alextrical/ESP8266-Sentinel-Kinetic-Wired-Remote/README.md

# ESP8266-Vent-Axia-Sentinel-Kinetic-Wired-Remote-Controller
ESP8266 based Re-implementation of the Vent-Axia Sentinel Kinetic Wired Remote Controller
Firmware to be checked over once the PCB is manufactured, but Arduino sketch can be simulated here
https://wokwi.com/projects/427157112827024385
