alextrical/ESP8266-Sentinel-Kinetic-Wired-Remote/Enclosure.stl

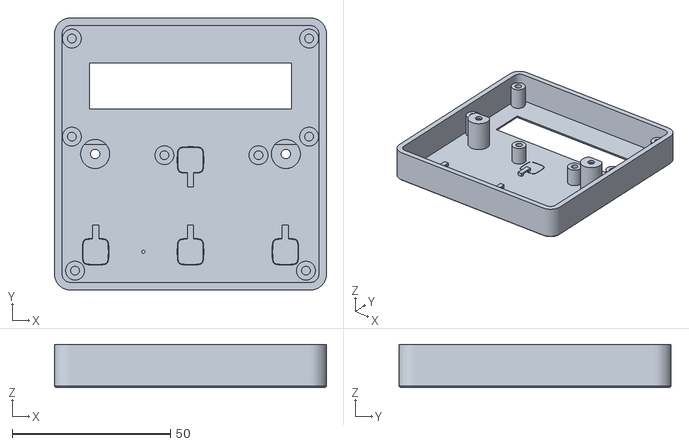
[picture p1: CAD file, 2025-04-12]
Enclosure.stl
86.0 x 86.0 x 13.6
