alextrical/ESP8266-Sentinel-Kinetic-Wired-Remote/ESP8266-Sentinel-Kinetic-Wired-Remote.pdf

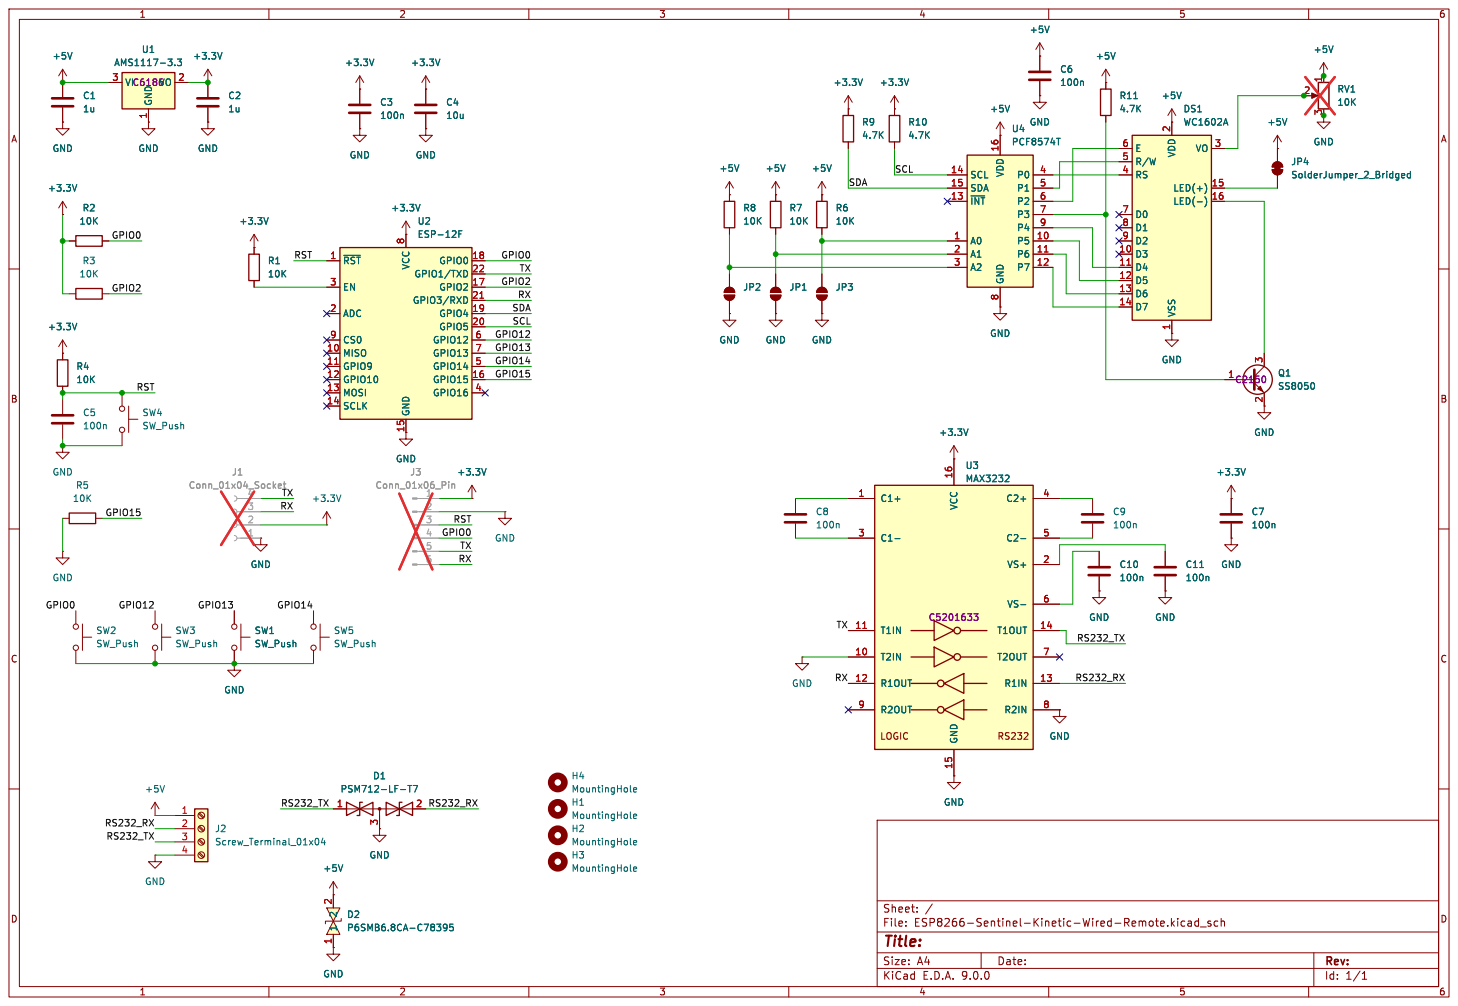
[picture p2: page 1]

8 GND 15 GPIO0 18 GPIO1/TXD 22 GPIO2 17 GPIO3/RXD 21 GPIO4 19 GPIO5 20 GPIO12 6 GPIO13 7 GPIO14 5 GPIO15 16 GPIO16 4 +3.3V GND GND
J3 Conn_01x06_Pin GND

Id: 1/1 Title: File: ESP8266-Sentinel-Kinetic-Wired-Remote.kicad_sch Sheet: / C8
