alextrical/ESP8266-Sentinel-Kinetic-Wired-Remote/ESP8266-Sentinel-Kinetic-Wired-Remote.kicad_pcb

## KiCad design ESP8266-Sentinel-Kinetic-Wired-Remote.kicad_pcb (2025-04-13)

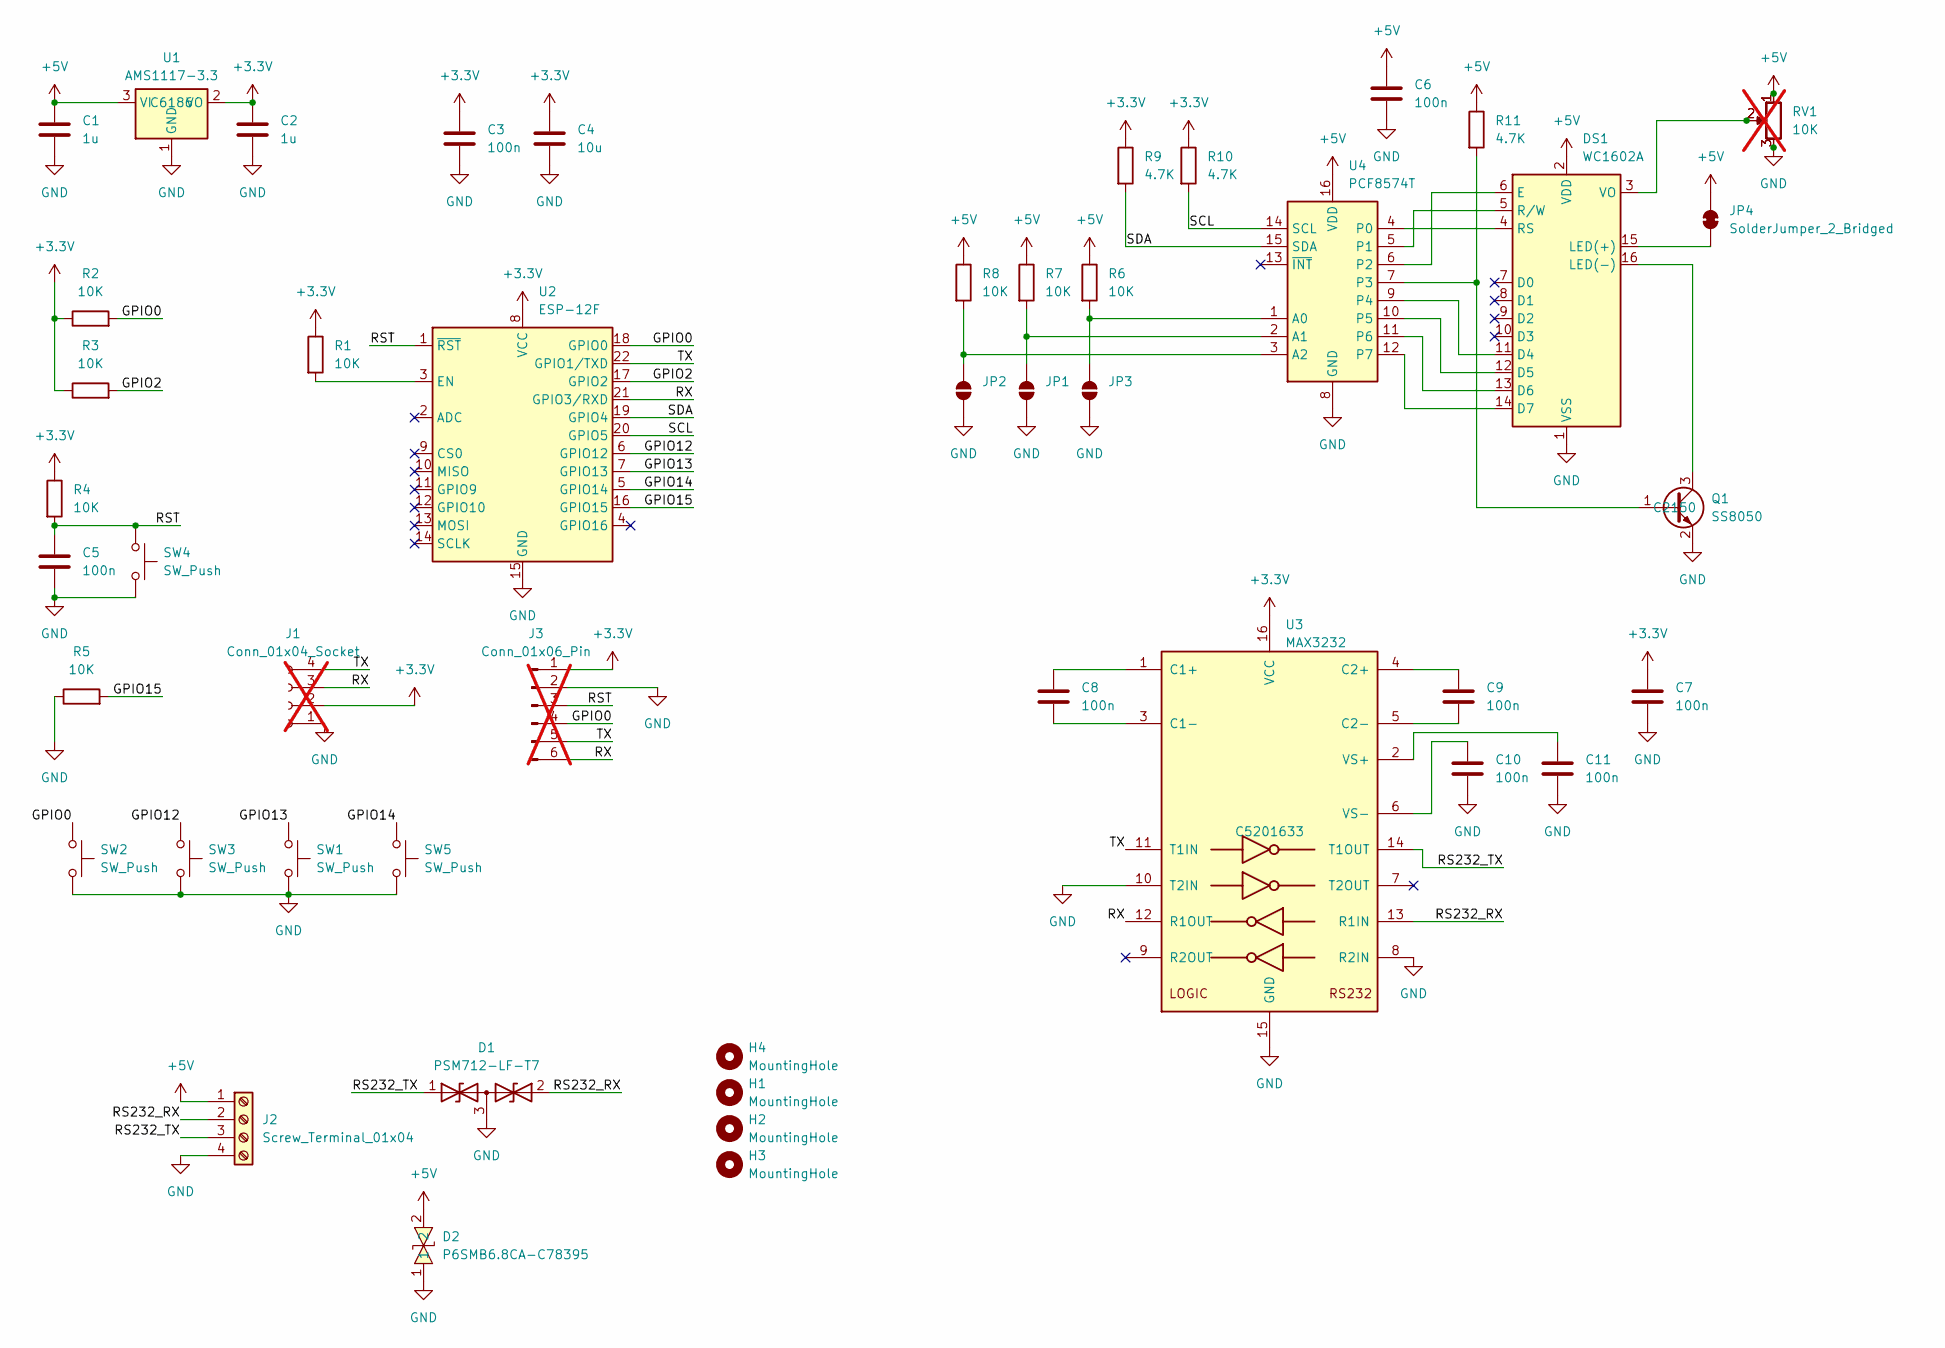
[picture p3: schematic ESP8266-Sentinel-Kinetic-Wired-Remote.kicad_sch]

Parts:
C1, C2: 1u; C_0402_1005Metric; LCSC C52923
C3, C5, C6, C7, C8, C9, C10, C11: 100n; C_0402_1005Metric; LCSC C307331
C4: 10u; C_0402_1005Metric; LCSC C15525
D1: PSM712-LF-T7; SOT-23; LCSC C32677
D2: P6SMB6.8CA-C78395; SMB_L4.6-W3.6-LS5.3-BI; LCSC Part C78395
DS1: WC1602A
H1, H2, H3, H4: MountingHole; MountingHole_3.2mm_M3
J1: Conn_01x04_Socket; PinSocket_1x04_P2.54mm_Vertical; not fitted
J2: Screw_Terminal_01x04; TerminalBlock_4Ucon_1x04_P3.50mm_Horizontal
J3: Conn_01x06_Pin; PinSocket_1x06_P1.27mm_Vertical; not fitted
JP1, JP2, JP3: SolderJumper_2_Open; SolderJumper-2_P1.3mm_Open_RoundedPad1.0x1.5mm
JP4: SolderJumper_2_Bridged; SolderJumper-2_P1.3mm_Bridged2Bar_RoundedPad1.0x1.5mm
Q1: SS8050; SOT-23; LCSC C2150
R1, R2, R3, R4, R5, R6, R7, R8: 10K; R_0402_1005Metric; LCSC C25744
R9, R10, R11: 4.7K; R_0402_1005Metric; LCSC C25900
RV1: 10K; Potentiometer_Runtron_RM-065_Vertical
RV2: 10K; Potentiometer_ACP_CA14V-15_Vertical; not fitted
SW1, SW2, SW3, SW4, SW5: SW_Push; SW_PUSH_6mm
U1: AMS1117-3.3; SOT-223-3_TabPin2; LCSC C6186
U2: ESP-12F; ESP-12E
U3: MAX3232; SOP-16_3.9x9.9mm_P1.27mm; LCSC C5201633
U4: PCF8574T; SOIC-16_3.9x9.9mm_P1.27mm; LCSC C5310792

Connections:
+3.3V: C2.1, C3.1, C4.1, C7.1, J1.2, J3.1, R1.1, R2.1, R3.1, R4.1, R9.1, R10.1, U1.2 (VO), U2.8 (VCC), U3.16 (VCC)
+5V: C1.1, C6.1, D2.2, DS1.2 (VDD), J2.1, JP4.2 (B), R6.1, R7.1, R8.1, R11.1, RV1.1, RV2.1, U1.3 (VI), U4.16 (VDD)
/GPIO0: J3.4, R2.2, SW2.1, U2.18 (GPIO0)
/GPIO2: R3.2, U2.17 (GPIO2)
/GPIO12: SW3.1, U2.6 (GPIO12)
/GPIO13: SW1.1, U2.7 (GPIO13)
/GPIO14: SW5.1, U2.5 (GPIO14)
/GPIO15: R5.2, U2.16 (GPIO15)
/RS232_RX: D1.2 (A2), J2.2, U3.13 (R1IN)
/RS232_TX: D1.1 (A1), J2.3, U3.14 (T1OUT)
/RST: C5.1, J3.3, R4.2, SW4.1, U2.1 (~RST)
/RX: J1.3, J3.6, U2.21 (GPIO3/RXD), U3.12 (R1OUT)
/SCL: R10.2, U2.20 (GPIO5), U4.14 (SCL)
/SDA: R9.2, U2.19 (GPIO4), U4.15 (SDA)
/TX: J1.4, J3.5, U2.22 (GPIO1/TXD), U3.11 (T1IN)
GND: C1.2, C2.2, C3.2, C4.2, C5.2, C6.2, C7.2, C10.2, C11.2, D1.3 (common), D2.1, DS1.1 (VSS), J1.1, J2.4, J3.2, JP1.1 (A), JP2.1 (A), JP3.1 (A), Q1.2 (E), R5.1, RV1.3, RV2.3, SW1.2, SW2.2, SW3.2, SW4.2, SW5.2, U1.1 (GND), U2.15 (GND), U3.8 (R2IN), U3.10 (T2IN), U3.15 (GND), U4.8 (GND)
unnamed: DS1.11 (D4), U4.9 (P4)
unnamed: DS1.12 (D5), U4.10 (P5)
unnamed: DS1.13 (D6), U4.11 (P6)
unnamed: DS1.14 (D7), U4.12 (P7)
unnamed: DS1.6 (E), U4.6 (P2)
unnamed: DS1.15 (LED(+)), JP4.1 (A)
unnamed: DS1.16 (LED(-)), Q1.3 (C)
unnamed: DS1.4 (RS), U4.4 (P0)
unnamed: DS1.5 (R/W), U4.5 (P1)
unnamed: DS1.3 (VO), RV1.2, RV2.2
unnamed: JP1.2 (B), R7.2, U4.2 (A1)
unnamed: JP2.2 (B), R8.2, U4.3 (A2)
unnamed: JP3.2 (B), R6.2, U4.1 (A0)
unnamed: Q1.1 (B), R11.2, U4.7 (P3)
unnamed: R1.2, U2.3 (EN)
unnamed: C8.1, U3.1 (C1+)
unnamed: C8.2, U3.3 (C1-)
unnamed: C9.1, U3.4 (C2+)
unnamed: C9.2, U3.5 (C2-)
unnamed: C11.1, U3.2 (VS+)
unnamed: C10.1, U3.6 (VS-)

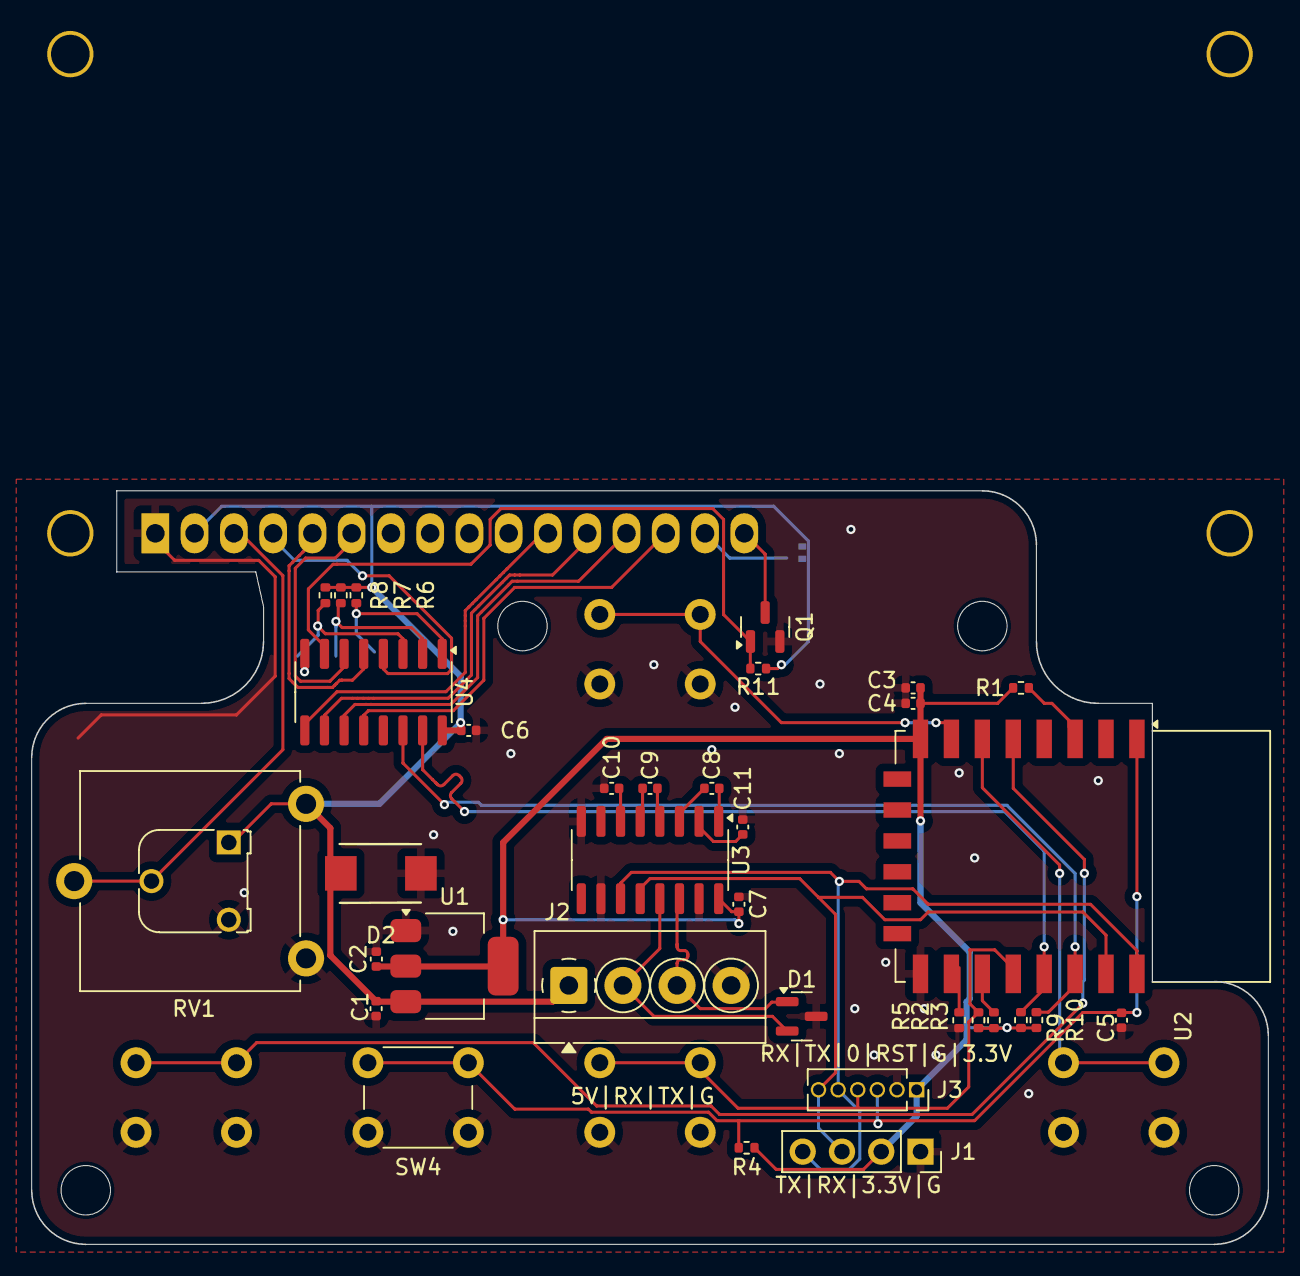
[picture p4: board ESP8266-Sentinel-Kinetic-Wired-Remote.kicad_pcb from above]

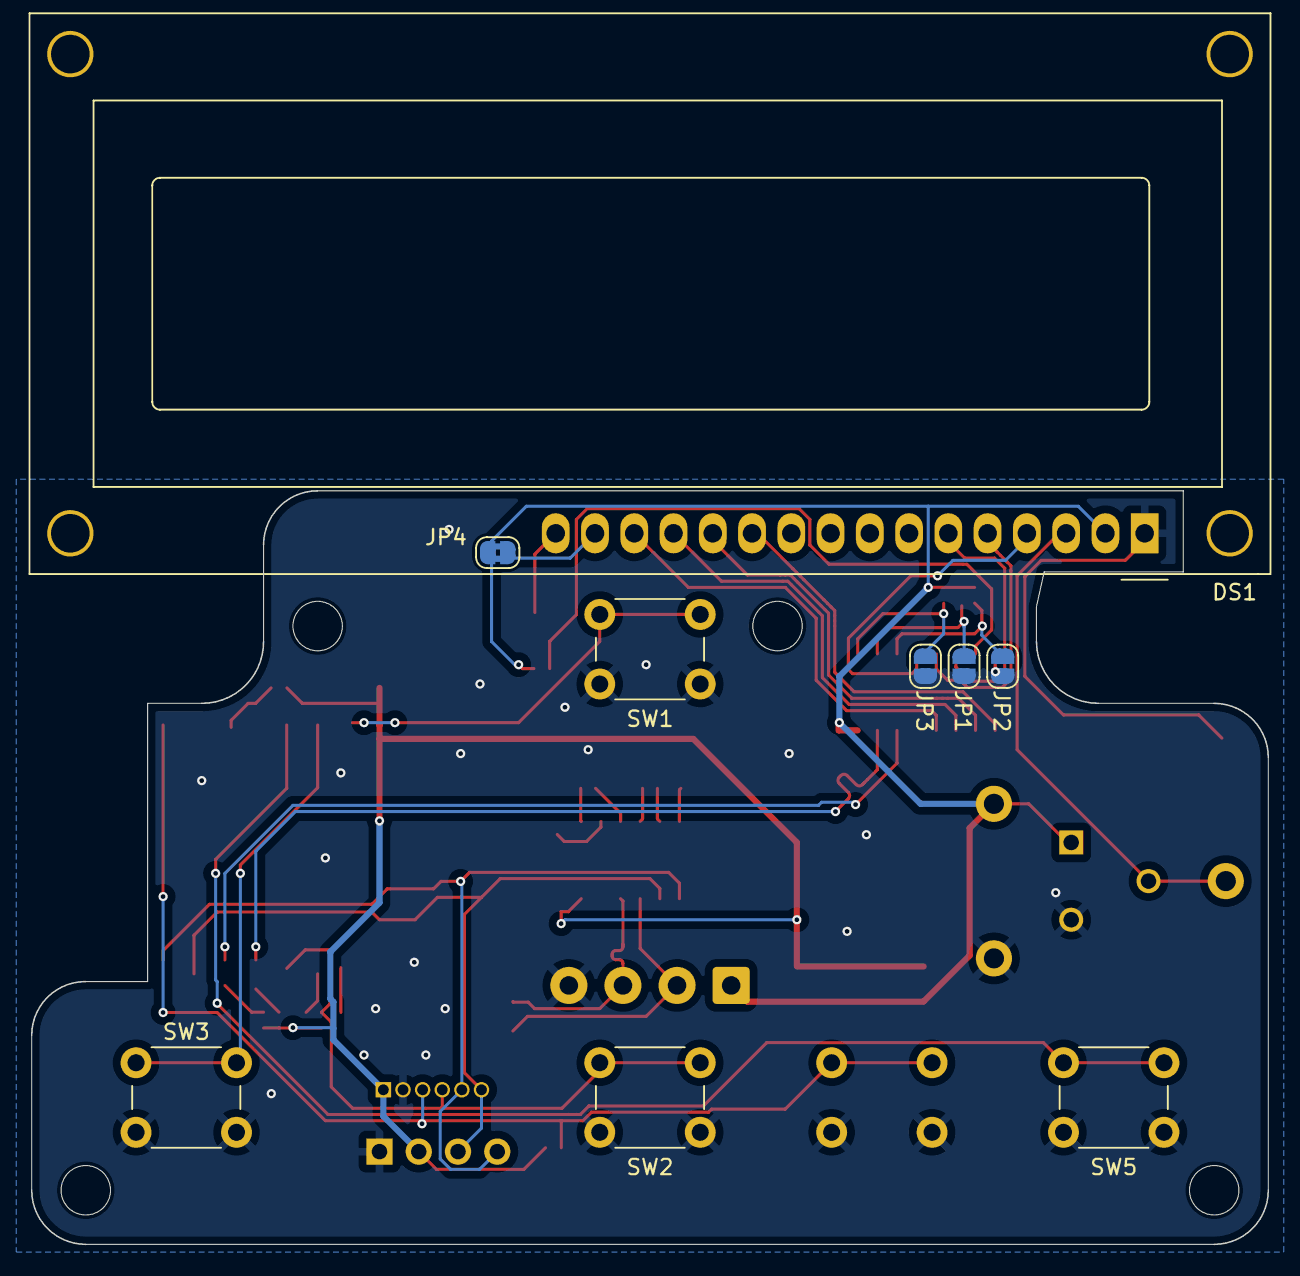
[picture p5: board ESP8266-Sentinel-Kinetic-Wired-Remote.kicad_pcb from below]

Board: 2 copper layers, 80.0 x 48.8 mm, 48 parts (9 on the bottom side), 37 nets.
