alextrical/ESP8266-Sentinel-Kinetic-Wired-Remote/(commit log)

2025-04-04 Initial schematic
    [ESP8266-Sentinel-Kinetic-Wired-Remote.kicad_sch]
2025-04-12 Layed out PCB and created 3D printable enclosure
    [ESP8266-Sentinel-Kinetic-Wired-Remote.kicad_pcb, ESP8266-Sentinel-Kinetic-Wired-Remote.kicad_sch, Enclosure.stl]
2025-04-13 Added JLCPCB part numbers Rotated programming ports
    [ESP8266-Sentinel-Kinetic-Wired-Remote.kicad_pcb, ESP8266-Sentinel-Kinetic-Wired-Remote.kicad_sch]
2025-04-13 Add JLCPCB part number for SS8050 Remove panel creation action
    [ESP8266-Sentinel-Kinetic-Wired-Remote.kicad_pcb, ESP8266-Sentinel-Kinetic-Wired-Remote.kicad_sch]
2025-04-13 Replaced PCF8574 package
    [ESP8266-Sentinel-Kinetic-Wired-Remote.kicad_pcb, ESP8266-Sentinel-Kinetic-Wired-Remote.kicad_sch]
2025-04-13 Added TVS diodes for protection
    [ESP8266-Sentinel-Kinetic-Wired-Remote.kicad_pcb, ESP8266-Sentinel-Kinetic-Wired-Remote.kicad_sch]
2025-04-22 Add Arduino based source code
2025-05-14 Upload schematic
